MaizeShark/Nikon-NMEA-Pro/Nikon-GPS.step

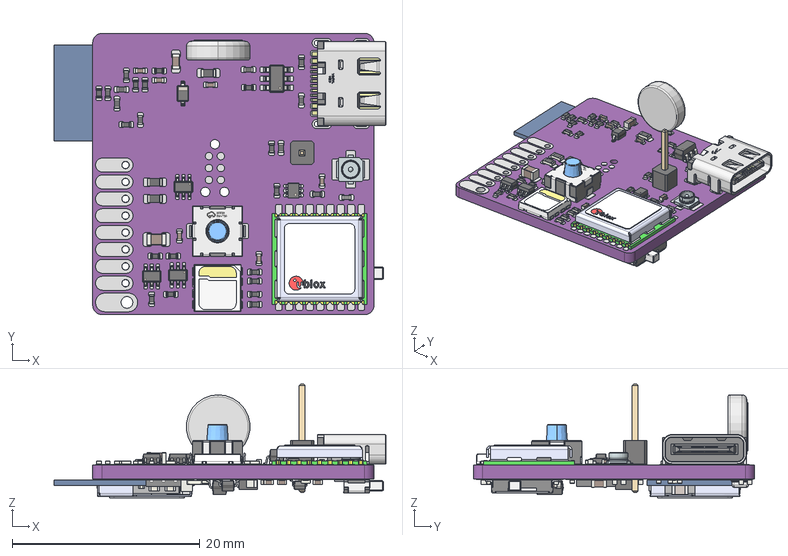
[picture p3: CAD file, 2026-11-05]
Nikon-GPS.step
35.4 x 30.0 x 12.1 mm
USB-C-SMD_G-SWITCH_GT-USB-7010ASV
C_0805_2012Metric x 2
D_SOD-323
C_0402_1005Metric x 14
GW J9LHS2.4M-C0C7-2+35+13+40AW-1 v4
R_0402_1005Metric x 32
R_0603_1608Metric x 3
SOT-363_SC-70-6 x 3
SOT_563
C_0603_1608Metric x 3
SOT-23-6
PinHeader_1x01_P254mm_Vertical
ML-621S_ZTN
KEY-SMD_2P-L5.3-W5.4-H4.3-LS5.4
u-blox_MAX_label_Default
Shield
MAX_PCB
L_0402_1005Metric
BMP581
SOT-23-5
SOT-23
R_Array_Convex_4x0603
WSON-8_L6.0-W5.0-H0.7-P1.27
LGA_12_2x2mm_P05mm
Extruded x 22
Extruded_2 x 3
Extruded_3 x 14
Extruded_4 x 2
Extruded_5
Extruded_6 x 12
Extruded_7 x 4
Extruded_8 x 2
Extruded_9 x 6
Extruded_10 x 3
Extruded_11
Extruded_12
Extruded_13 x 2
Extruded_14
BMD-340-341-pads
label_8x8
logo_x_4mm
logo_o_4mm
logo_l_4mm
logo_b_4mm
logo_u_4mm
pcb_1500_1020_056
BODY-SOT
LEAD-SOT x 6
PIN1-ID
Nikon-GPS-unsaved-export-hQPBzj_pad
Nikon-GPS-unsaved-export-hQPBzj_PCB
