MaizeShark/Nikon-NMEA-Pro/3D/FTSH-105-01-F-DV-K-P-TR.stp

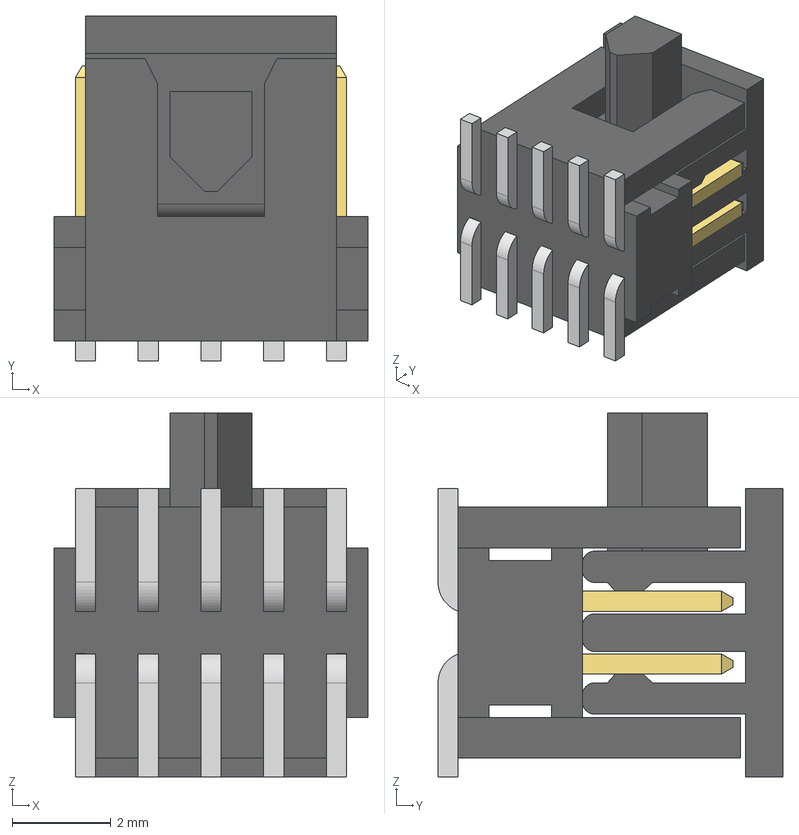
[picture p4: CAD file, 2026-10-20]
3D/FTSH-105-01-F-DV-K-P-TR.stp
6.35 x 6.98 x 7.37 mm
FTSH-105-01-F-DV-K-P-TR_body
FTSH-105-01-F-DV-K-P-TR_pins1
FTSH-105-01-F-DV-K-P-TR_pins2
FTSH-105-01-F-DV-K-P-TR_pp_pad
