MaizeShark/Nikon-NMEA-Pro/3D/VQFN-16_L3.0-W3.0-P0.50-TL-EP1.5.step

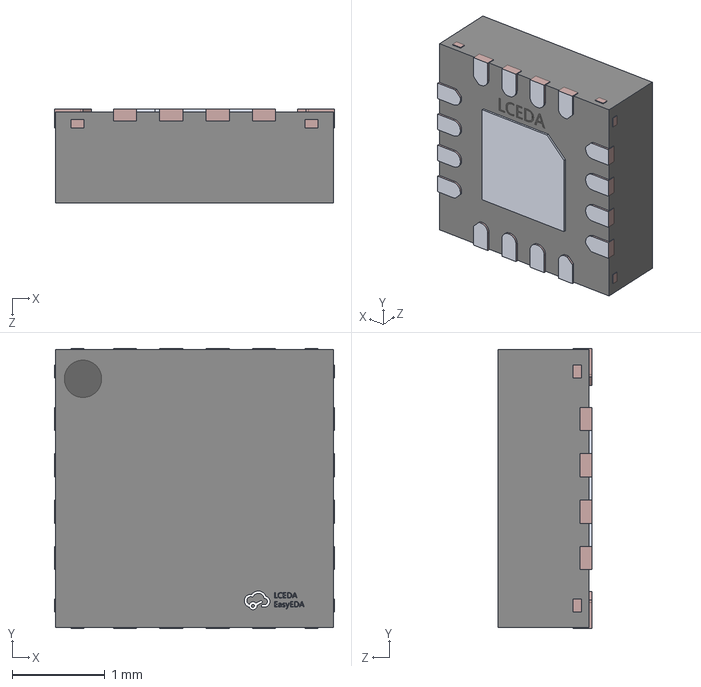
[picture p6: CAD file, 2026-10-20]
3D/VQFN-16_L3.0-W3.0-P0.50-TL-EP1.5.step
3.02 x 3.02 x 1.01 mm
