MaizeShark/Nikon-NMEA-Pro/3D/GW_J9LHS2.4M-C0C7-2+35+13+40AW-1.stp

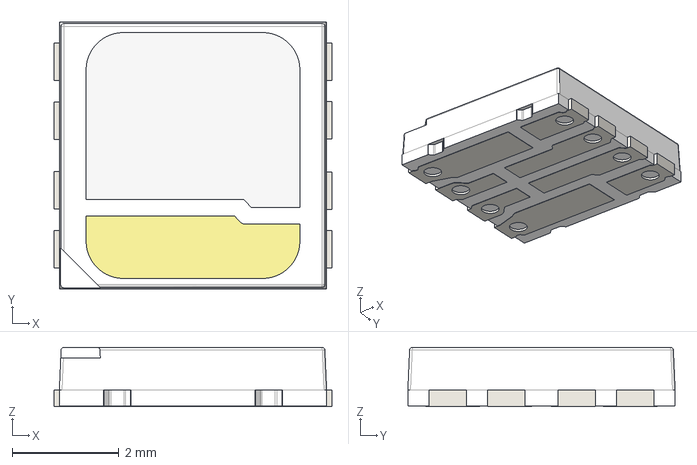
[picture p7: CAD file, 2026-10-20]
3D/GW_J9LHS2.4M-C0C7-2+35+13+40AW-1.stp
5.20 x 5.00 x 1.11 mm
