MaizeShark/Nikon-NMEA-Pro/3D/KEY-SMD_2P-L5.3-W5.4-H4.3-LS5.4.step

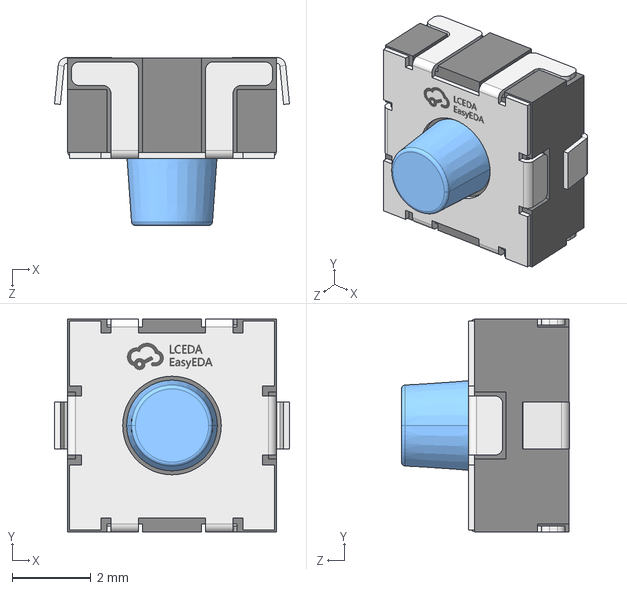
[picture p8: CAD file, 2026-10-20]
3D/KEY-SMD_2P-L5.3-W5.4-H4.3-LS5.4.step
5.96 x 5.40 x 4.26 mm
