MaizeShark/Nikon-NMEA-Pro/3D/SW-SMD_MSK12CO2-BDM.step

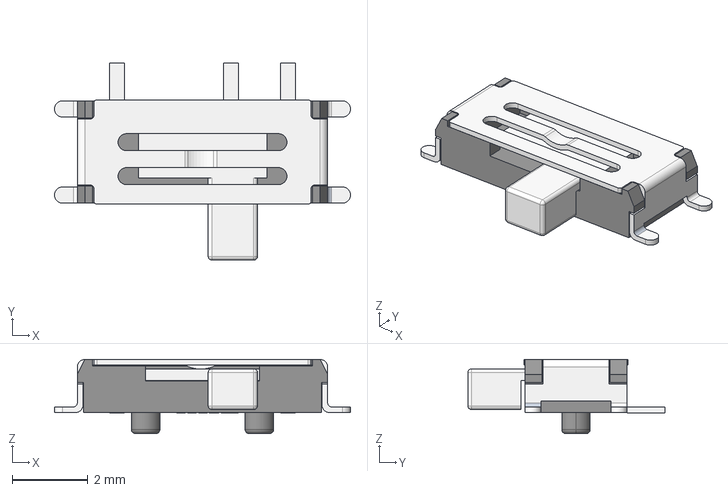
[picture p9: CAD file, 2026-10-20]
3D/SW-SMD_MSK12CO2-BDM.step
7.80 x 5.20 x 1.95 mm
