MaizeShark/Nikon-NMEA-Pro/3D/2042860001.stp

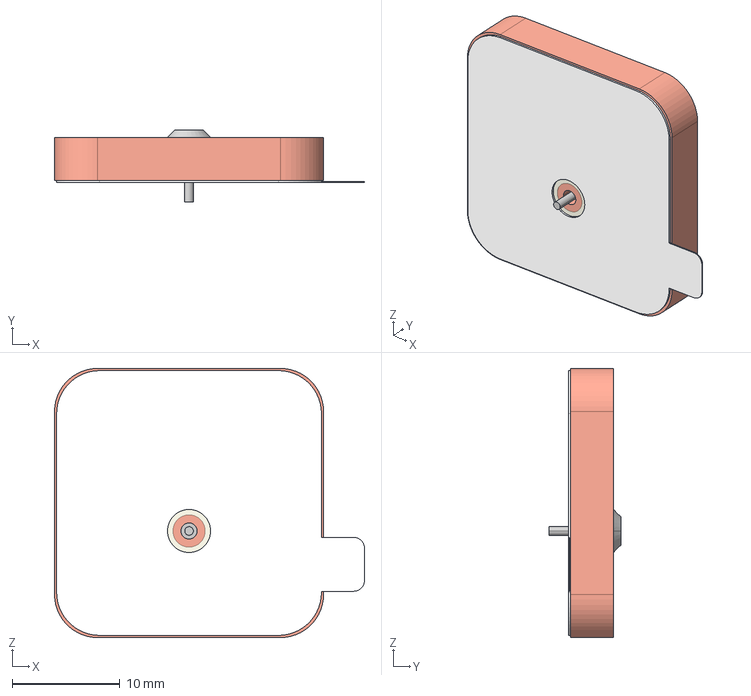
[picture p10: CAD file, 2026-10-20]
3D/2042860001.stp
28.8 x 6.70 x 25.0 mm
