MaizeShark/Nikon-NMEA-Pro/Nikon-GPS.kicad_pcb

## KiCad design Nikon-GPS.kicad_pcb (2026-11-05)

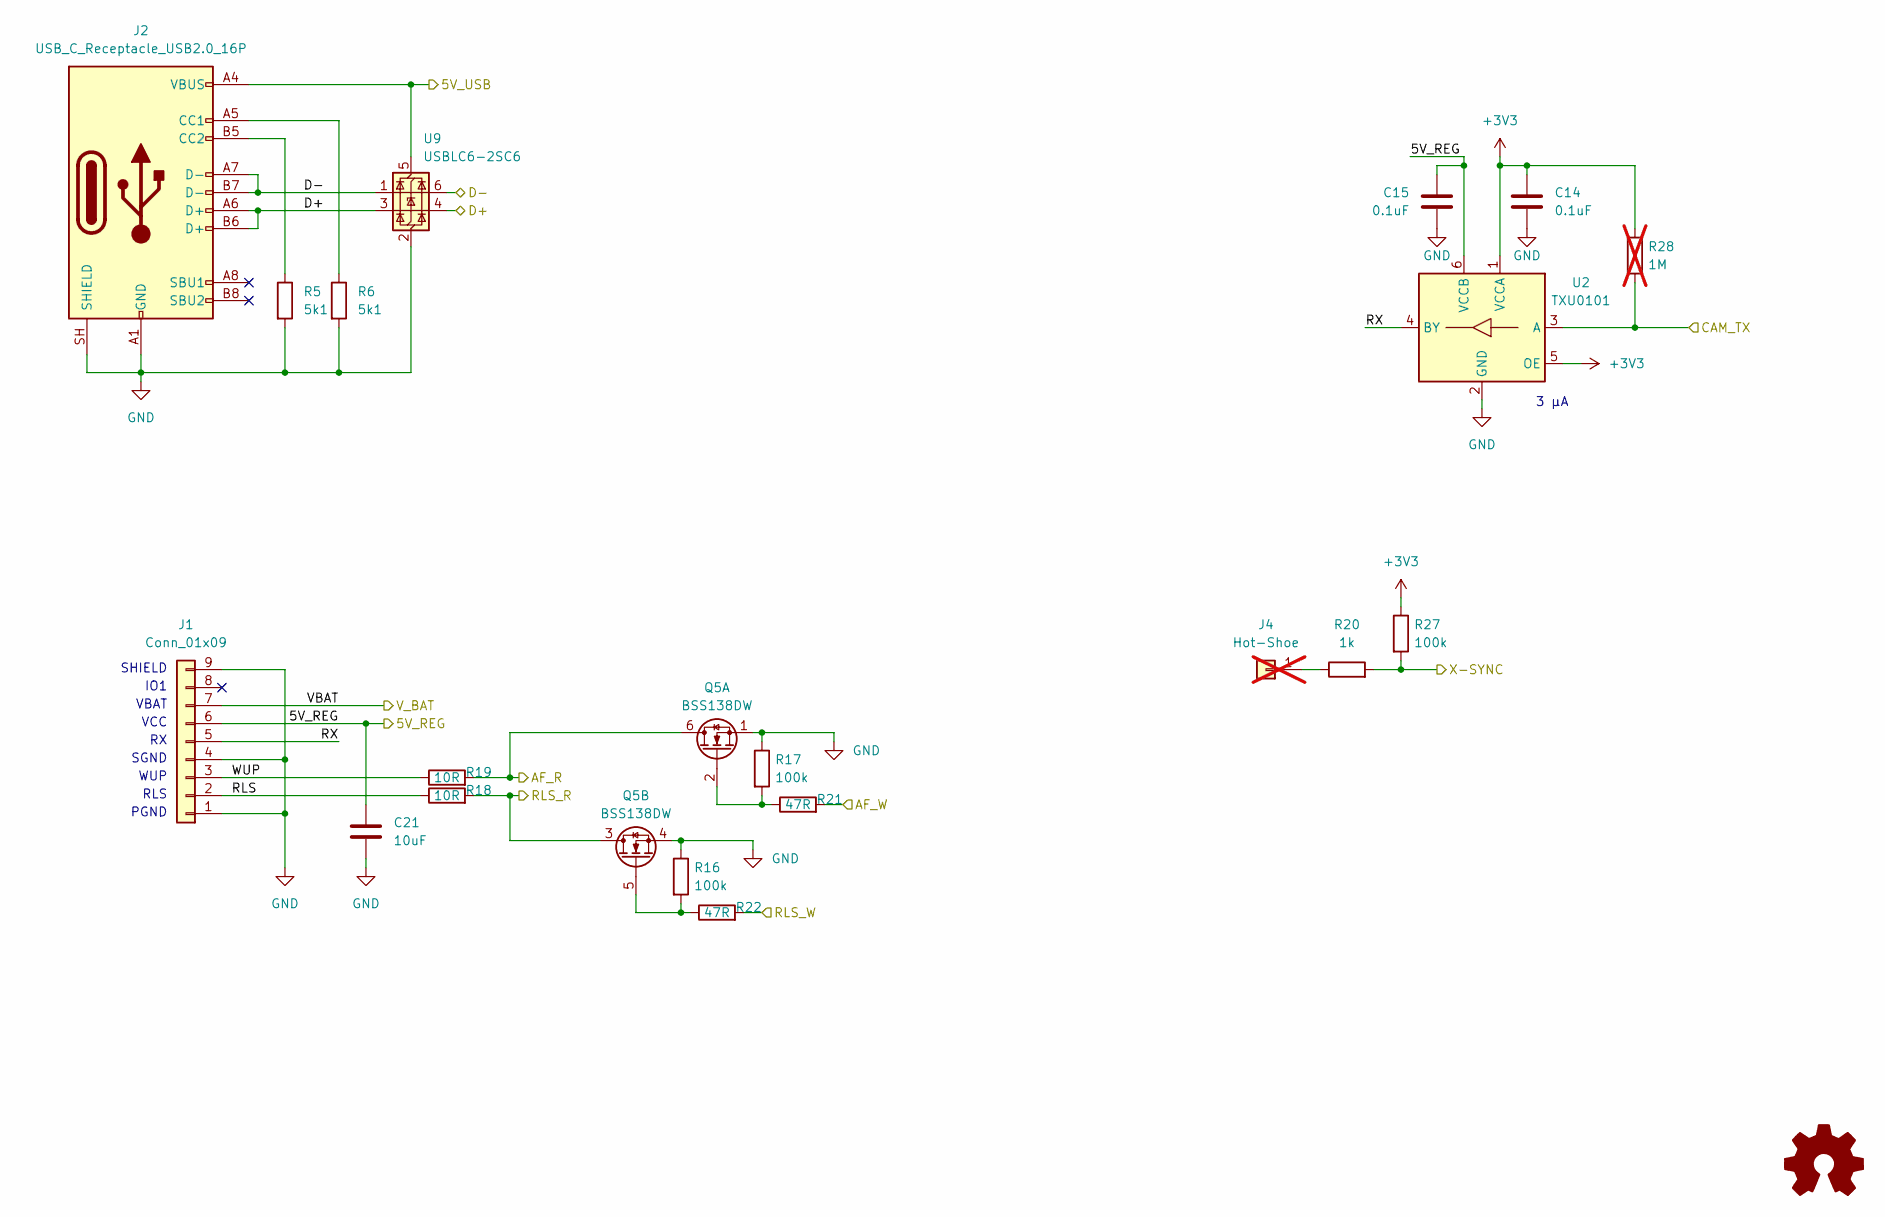
[picture p11: schematic connector.kicad_sch]

Parts:
C14, C15: 0.1uF; C_0402_1005Metric; LCSC C77020
C21: 10uF; C_0805_2012Metric; LCSC C32635
J1: Conn_01x09; Nikon Connector
J2: USB_C_Receptacle_USB2.0_16P; USB_C_Receptacle_G-Switch_GT-USB-7010ASV; LCSC C2988369
J4: Hot-Shoe; PinHeader_1x01_P2.54mm_Vertical; not fitted
Q5: BSS138DW; SOT-363_SC-70-6; LCSC C154900
R5, R6: 5k1; R_0402_1005Metric; LCSC C105872
R16, R17, R27: 100k; R_0402_1005Metric; LCSC C60491
R18, R19: 10R; R_0603_1608Metric; LCSC C109318
R20: 1k; R_0402_1005Metric; LCSC C106235
R21, R22: 47R; R_0402_1005Metric; LCSC C137973
R28: 1M; R_0402_1005Metric; LCSC C138033; not fitted
U2: TXU0101; Texas_DCK0006A_2.1x2mm_P0.65mm; LCSC C5217868
U9: USBLC6-2SC6; SOT-23-6; LCSC C5261088

Connections:
+3V3: C14.1, R27.1, R28.1, U2.1 (VCCA), U2.5 (OE); also elsewhere on the board
/Connector/5V_REG: C15.1, C21.1, J1.6, U2.6 (VCCB); also elsewhere on the board
/Connector/5V_USB: J2.A4 (VBUS), J2.A9 (VBUS), J2.B4 (VBUS), J2.B9 (VBUS), U9.5 (VBUS); also elsewhere on the board
/Connector/AF_R: Q5.6 (D1), R19.2; also elsewhere on the board
/Connector/AF_W: R21.2; also elsewhere on the board
/Connector/CAM_TX: R28.2, U2.3 (A); also elsewhere on the board
/Connector/D+: J2.A6 (D+), J2.B6 (D+), U9.3 (I/O2), U9.4 (I/O2); also elsewhere on the board
/Connector/D-: J2.A7 (D-), J2.B7 (D-), U9.1 (I/O1), U9.6 (I/O1); also elsewhere on the board
/Connector/RLS: J1.2, R18.1
/Connector/RLS_R: Q5.3 (D2), R18.2; also elsewhere on the board
/Connector/RLS_W: R22.2; also elsewhere on the board
/Connector/RX: J1.5, U2.4 (BY)
/Connector/VBAT: J1.7; also elsewhere on the board
/Connector/WUP: J1.3, R19.1
/Connector/X-SYNC: R20.2, R27.2; also elsewhere on the board
GND: C14.2, C15.2, C21.2, J1.1, J1.4, J1.9, J2.A1 (GND), J2.A12 (GND), J2.B1 (GND), J2.B12 (GND), J2.SH (SHIELD), Q5.1 (S1), Q5.4 (S2), R5.2, R6.2, R16.1, R17.1, U2.2 (GND), U9.2 (GND); also elsewhere on the board
unnamed: J2.A5 (CC1), R6.1
unnamed: J2.B5 (CC2), R5.1
unnamed: J4.1 (Pin_1_1), R20.1
unnamed: Q5.2 (G1), R17.2, R21.1
unnamed: Q5.5 (G2), R16.2, R22.1

Notes on the sheet:
VBAT
WUP
RLS
PGND
IO1
3 μA
SGND
SHIELD
VCC

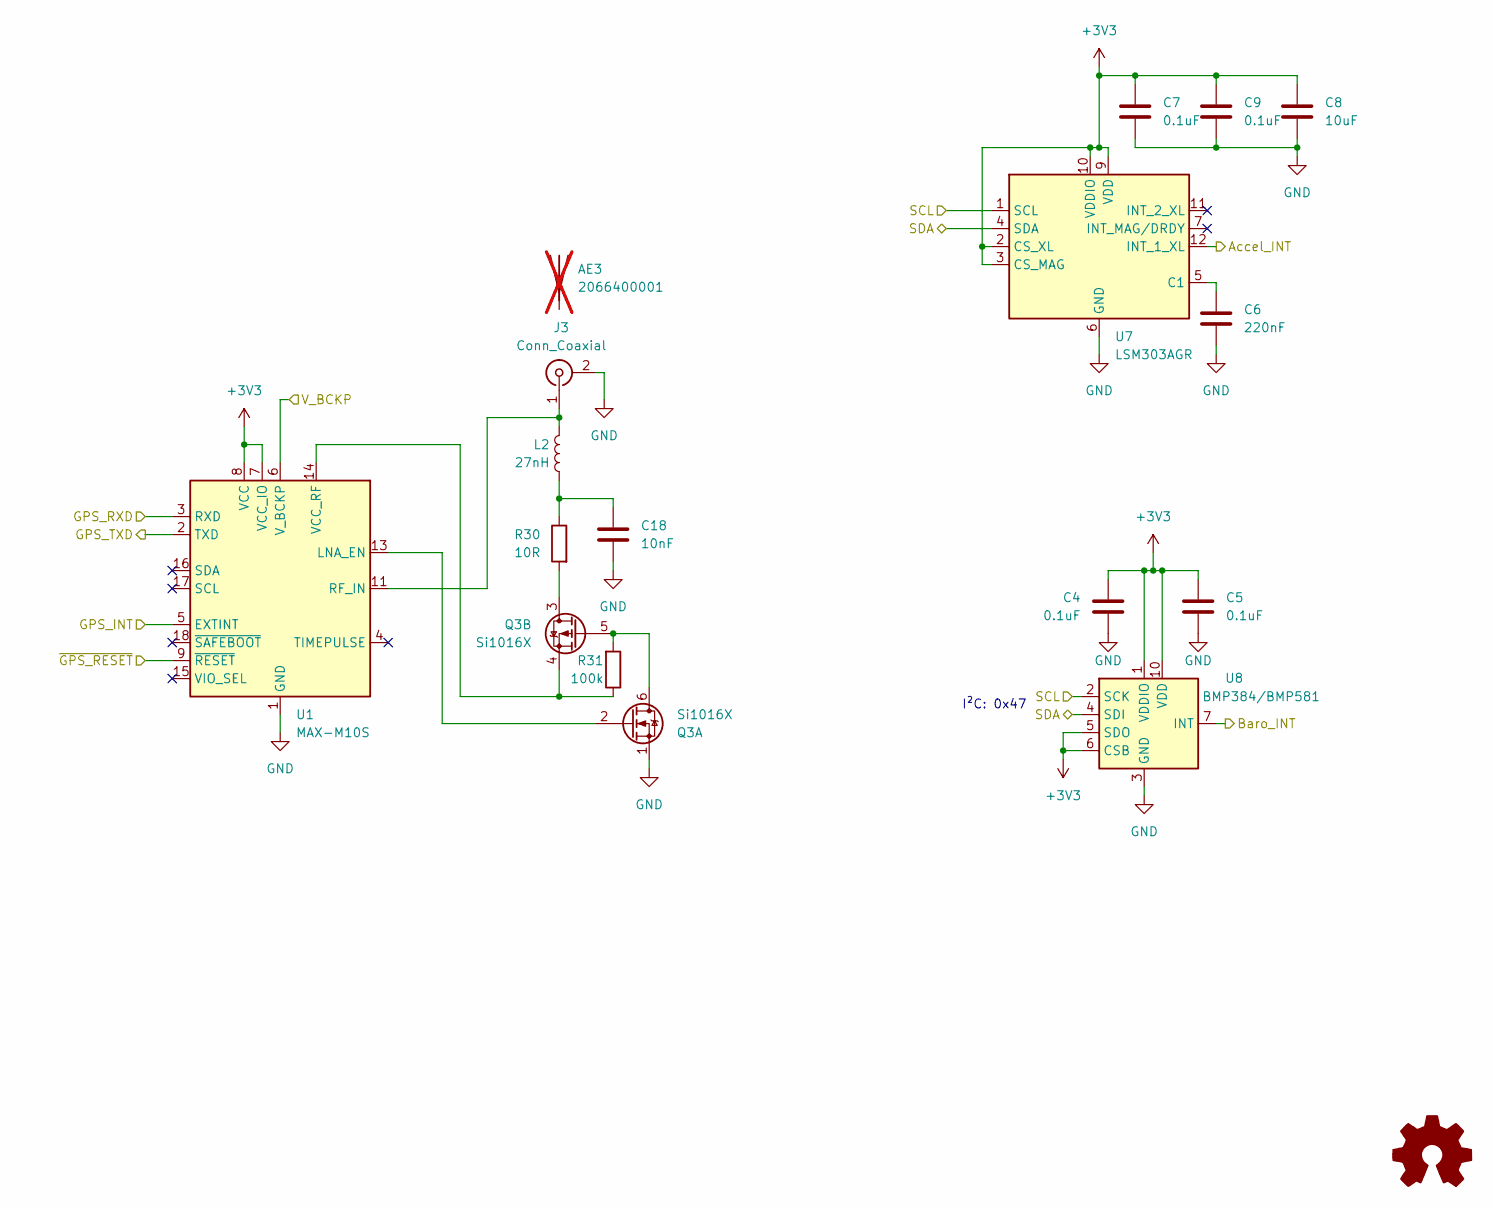
[picture p12: schematic sensors.kicad_sch]

Parts:
AE3: 2066400001; 2042860001; LCSC C841211; not fitted
C4, C5, C7, C9: 0.1uF; C_0402_1005Metric; LCSC C77020
C6: 220nF; C_0402_1005Metric; LCSC C696846
C8: 10uF; C_0603_1608Metric; LCSC C19702
C18: 10nF; C_0402_1005Metric; LCSC C85735
J3: Conn_Coaxial; U.FL_Molex_MCRF_73412-0110_Vertical; LCSC C41375966
L2: 27nH; L_0402_1005Metric; LCSC C12669
Q3: Si1016X; SOT-563; LCSC C50314620
R30: 10R; R_0402_1005Metric; LCSC C138066
R31: 100k; R_0402_1005Metric; LCSC C60491
U1: MAX-M10S; ublox_MAX; LCSC C4153167
U7: LSM303AGR; LGA-12_2x2mm_P0.5mm; LCSC C126671
U8: BMP384/BMP581; Bosch_WFLGA-10_2x2mm_P0.5mm; LCSC C5362283

Connections:
+3V3: C4.1, C5.1, C7.1, C8.1, C9.1, U1.7 (VCC_IO), U1.8 (VCC), U7.2 (CS_XL), U7.3 (CS_MAG), U7.9 (VDD), U7.10 (VDDIO), U8.1 (VDDIO), U8.5 (SDO), U8.6 (CSB), U8.10 (VDD); also elsewhere on the board
/MCU/Accel_INT: U7.12 (INT_1_XL); also elsewhere on the board
/MCU/Baro_INT: U8.7 (INT); also elsewhere on the board
/MCU/GPS_INT: U1.5 (EXTINT); also elsewhere on the board
/MCU/GPS_RXD: U1.2 (TXD); also elsewhere on the board
/MCU/GPS_TXD: U1.3 (RXD); also elsewhere on the board
/MCU/SCL: U7.1 (SCL), U8.2 (SCK); also elsewhere on the board
/MCU/SDA: U7.4 (SDA), U8.4 (SDI); also elsewhere on the board
/MCU/~GPS_RESET: U1.9 (~RESET); also elsewhere on the board
/Power/V_BCKP: U1.6 (V_BCKP); also elsewhere on the board
GND: C4.2, C5.2, C6.2, C7.2, C8.2, C9.2, C18.2, J3.2 (Ext), Q3.1 (SN), U1.1 (GND), U1.10 (GND), U1.12 (GND), U7.6 (GND), U7.8 (GND), U8.3 (GND), U8.8 (GND), U8.9 (GND), U8.[8,9] (GND); also elsewhere on the board
unnamed: C18.1, L2.2, R30.1
unnamed: J3.1 (In), L2.1, U1.11 (RF_IN)
unnamed: Q3.5 (GP), Q3.6 (DN), R31.2
unnamed: Q3.2 (GN), U1.13 (LNA_EN)
unnamed: Q3.3 (DP), R30.2
unnamed: Q3.4 (SP), R31.1, U1.14 (VCC_RF)
unnamed: C6.1, U7.5 (C1)

Notes on the sheet:
I²C: 0x47

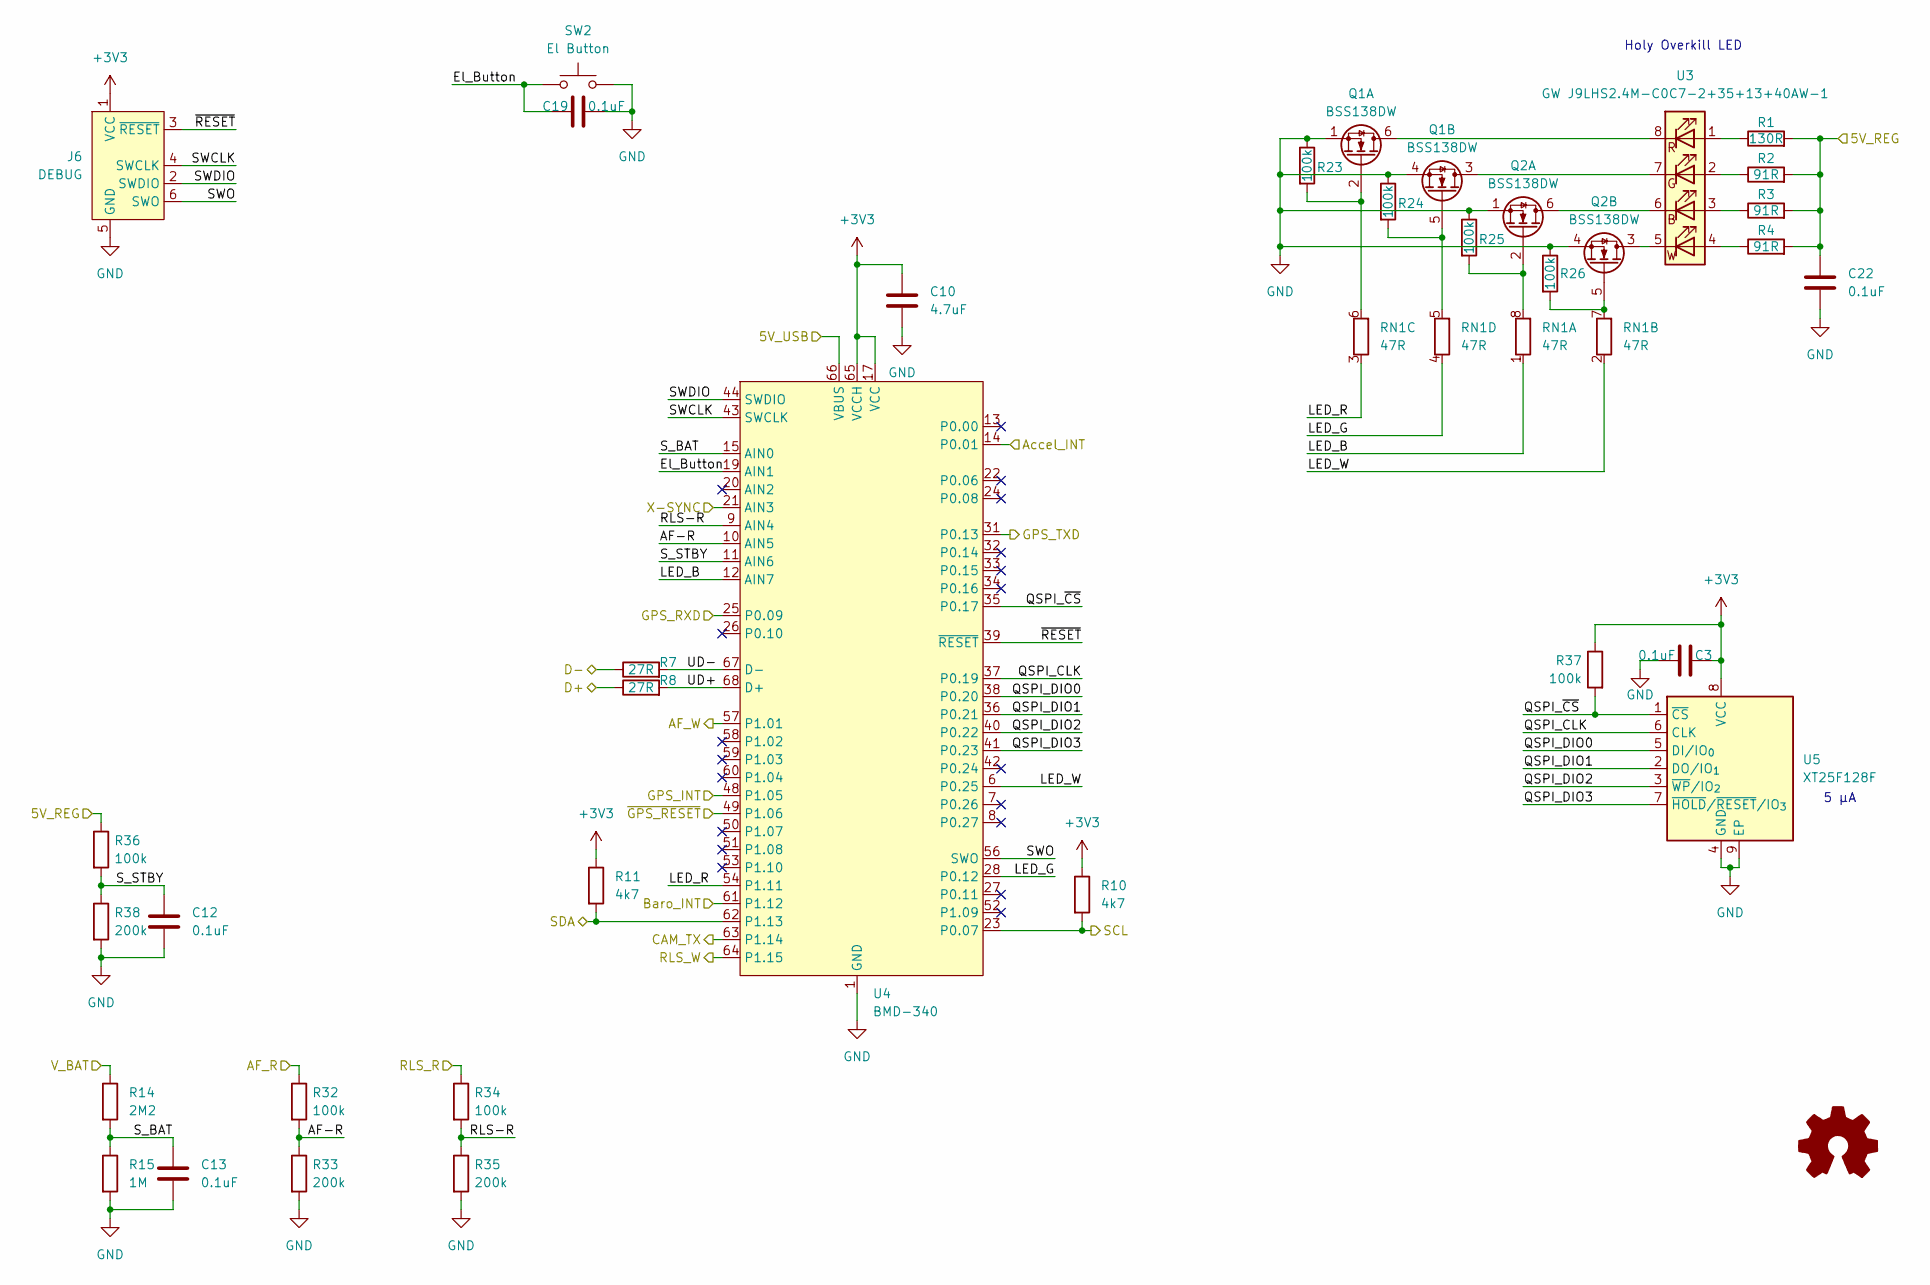
[picture p13: schematic mcu.kicad_sch]

Parts:
C3, C12, C13, C19, C22: 0.1uF; C_0402_1005Metric; LCSC C77020
C10: 4.7uF; C_0603_1608Metric; LCSC C1705
J6: DEBUG; Tag-Connect_TC2030-IDC-NL_2x03_P1.27mm_Vertical
Q1, Q2: BSS138DW; SOT-363_SC-70-6; LCSC C154900
R1: 130R; R_0402_1005Metric; LCSC C413066
R2, R3, R4: 91R; R_0402_1005Metric; LCSC C2998110
R7, R8: 27R; R_0402_1005Metric; LCSC C2909343
R10, R11: 4k7; R_0402_1005Metric; LCSC C105871
R14: 2M2; R_0402_1005Metric; LCSC C2998080
R15: 1M; R_0402_1005Metric; LCSC C138033
R23, R24, R25, R26, R32, R34, R36, R37: 100k; R_0402_1005Metric; LCSC C60491
R33, R35, R38: 200k; R_0402_1005Metric; LCSC C2906866
RN1: 47R; R_Array_Convex_4x0603; LCSC C16081
SW2: El Button; SKSUAAE010
U3: GW J9LHS2.4M-C0C7-2+35+13+40AW-1; GW J9LHS2.4M; LCSC C5648656
U4: BMD-340; LCSC C5456944
U5: XT25F128F; WSON-8-1EP_6x5mm_P1.27mm_EP3.4x4mm; LCSC C3202839

Connections:
+3V3: C3.2, C10.1, J6.1 (VCC), R10.1, R11.1, R37.1, U4.17 (VCC), U4.65 (VCCH), U5.8 (VCC); also elsewhere on the board
/Connector/5V_REG: C22.1, R1.2, R2.2, R3.2, R4.2, R36.1; also elsewhere on the board
/Connector/5V_USB: U4.66 (VBUS); also elsewhere on the board
/Connector/AF_R: R32.1; also elsewhere on the board
/Connector/AF_W: U4.57 (P1.01); also elsewhere on the board
/Connector/CAM_TX: U4.63 (P1.14); also elsewhere on the board
/Connector/D+: R8.1; also elsewhere on the board
/Connector/D-: R7.1; also elsewhere on the board
/Connector/RLS_R: R34.1; also elsewhere on the board
/Connector/RLS_W: U4.64 (P1.15); also elsewhere on the board
/Connector/VBAT: R14.1; also elsewhere on the board
/Connector/X-SYNC: U4.21 (AIN3); also elsewhere on the board
/MCU/AF-R: R32.2, R33.1, U4.10 (AIN5)
/MCU/Accel_INT: U4.14 (P0.01); also elsewhere on the board
/MCU/Baro_INT: U4.61 (P1.12); also elsewhere on the board
/MCU/El_Button: C19.1, SW2.1, U4.19 (AIN1)
/MCU/GPS_INT: U4.48 (P1.05); also elsewhere on the board
/MCU/GPS_RXD: U4.25 (P0.09); also elsewhere on the board
/MCU/GPS_TXD: U4.31 (P0.13); also elsewhere on the board
/MCU/LED_B: RN1.1 (R1.1), U4.12 (AIN7)
/MCU/LED_G: RN1.4 (R4.1), U4.28 (P0.12)
/MCU/LED_R: RN1.3 (R3.1), U4.54 (P1.11)
/MCU/LED_W: RN1.2 (R2.1), U4.6 (P0.25)
/MCU/QSPI_CLK: U4.37 (P0.19), U5.6 (CLK)
/MCU/QSPI_DIO0: U4.38 (P0.20), U5.5 (DI/IO_{0})
/MCU/QSPI_DIO1: U4.36 (P0.21), U5.2 (DO/IO_{1})
/MCU/QSPI_DIO2: U4.40 (P0.22), U5.3 (~WP/IO_{2})
/MCU/QSPI_DIO3: U4.41 (P0.23), U5.7 (~HOLD/~RESET/IO_{3})
/MCU/QSPI_~CS: R37.2, U4.35 (P0.17), U5.1 (~CS)
/MCU/RLS-R: R34.2, R35.1, U4.9 (AIN4)
/MCU/SCL: R10.2, U4.23 (P0.07); also elsewhere on the board
/MCU/SDA: R11.2, U4.62 (P1.13); also elsewhere on the board
/MCU/SWCLK: J6.4 (SWCLK), U4.43 (SWCLK)
/MCU/SWDIO: J6.2 (SWDIO), U4.44 (SWDIO)
/MCU/SWO: J6.6 (SWO), U4.56 (SWO)
/MCU/S_BAT: C13.1, R14.2, R15.1, U4.15 (AIN0)
/MCU/S_STBY: C12.1, R36.2, R38.1, U4.11 (AIN6)
/MCU/UD+: R8.2, U4.68 (D+)
/MCU/UD-: R7.2, U4.67 (D-)
/MCU/~GPS_RESET: U4.49 (P1.06); also elsewhere on the board
/MCU/~RESET: J6.3 (~RESET), U4.39 (~RESET)
GND: C3.1, C10.2, C12.2, C13.2, C19.2, C22.2, J6.5 (GND), Q1.1 (S1), Q1.4 (S2), Q2.1 (S1), Q2.4 (S2), R15.2, R23.1, R24.1, R25.1, R26.1, R33.2, R35.2, R38.2, SW2.2, U4.1 (GND), U4.2 (GND), U4.3 (GND), U4.4 (GND), U4.5 (GND), U4.16 (GND), U4.18 (GND), U4.29 (GND), U4.30 (GND), U4.45 (GND), U4.46 (GND), U4.47 (GND), U4.55 (GND), U4.[2-5,16,18,29,30,45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 (GND), U5.4 (GND), U5.9 (EP); also elsewhere on the board
unnamed: Q1.6 (D1), U3.8 (RK)
unnamed: Q1.2 (G1), R23.2, RN1.6 (R3.2)
unnamed: Q1.3 (D2), U3.7 (GK)
unnamed: Q1.5 (G2), R24.2, RN1.5 (R4.2)
unnamed: Q2.6 (D1), U3.6 (BK)
unnamed: Q2.2 (G1), R25.2, RN1.8 (R1.2)
unnamed: Q2.3 (D2), U3.5 (WK)
unnamed: Q2.5 (G2), R26.2, RN1.7 (R2.2)
unnamed: R3.1, U3.3 (BA)
unnamed: R2.1, U3.2 (GA)
unnamed: R1.1, U3.1 (RA)
unnamed: R4.1, U3.4 (WA)

Notes on the sheet:
Holy Overkill LED
5 μA

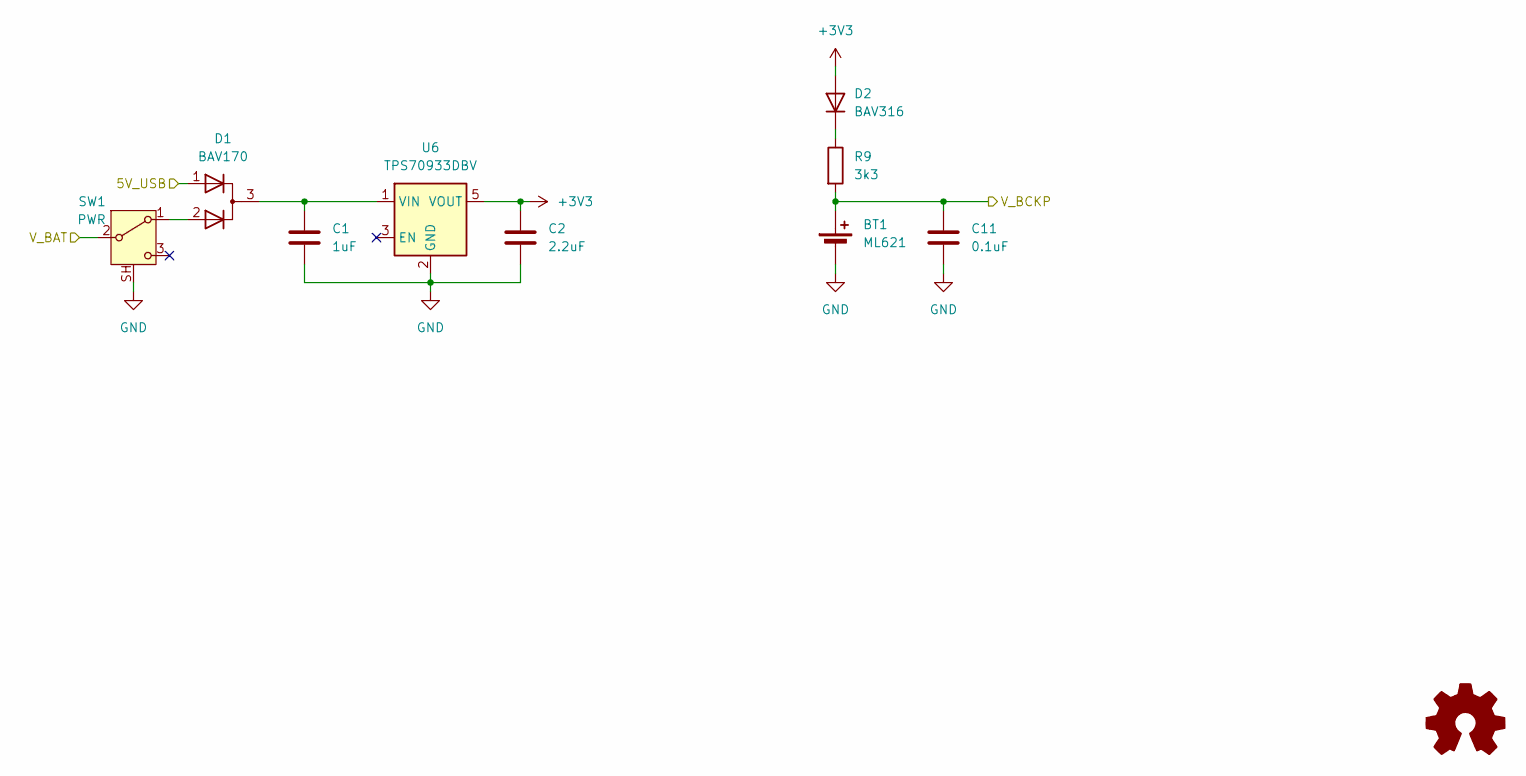
[picture p14: schematic power.kicad_sch]

Parts:
BT1: ML621; Battery_Panasonic_ML621_Vertical
C1: 1uF; C_0805_2012Metric; LCSC C344178
C2: 2.2uF; C_0603_1608Metric; LCSC C57895
C11: 0.1uF; C_0402_1005Metric; LCSC C77020
D1: BAV170; SOT-23; LCSC C109309
D2: BAV316; D_SOD-323; LCSC C3031914
R9: 3k3; R_0603_1608Metric; LCSC C22978
SW1: PWR; SW_SPDT_Shouhan_MSK12C02; LCSC C2681566
U6: TPS70933DBV; SOT-23-5_HandSoldering; LCSC C90991

Connections:
+3V3: C2.1, D2.2 (A), U6.5 (VOUT); also elsewhere on the board
/Connector/5V_USB: D1.1 (A); also elsewhere on the board
/Connector/VBAT: SW1.2 (B); also elsewhere on the board
/Power/V_BCKP: BT1.1 (+), C11.1, R9.2; also elsewhere on the board
GND: BT1.2 (-), C1.2, C2.2, C11.2, SW1.SH (MP), U6.2 (GND); also elsewhere on the board
unnamed: C1.1, D1.3 (K), U6.1 (VIN)
unnamed: D2.1 (K), R9.1
unnamed: D1.2 (A), SW1.1 (A)

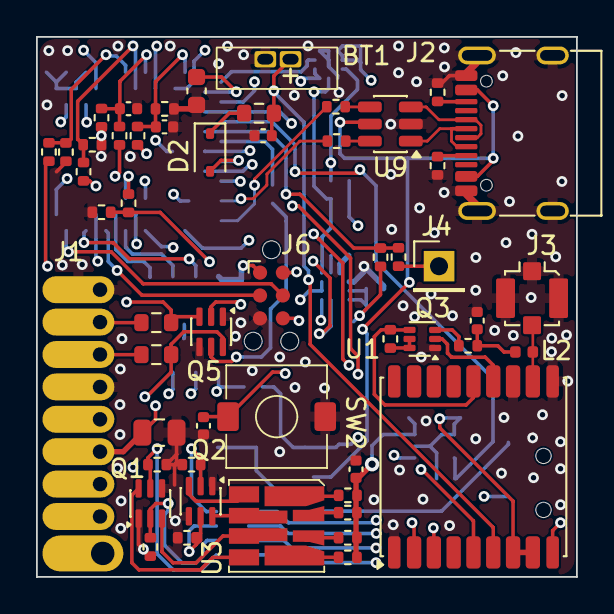
[picture p15: board Nikon-GPS.kicad_pcb from above]

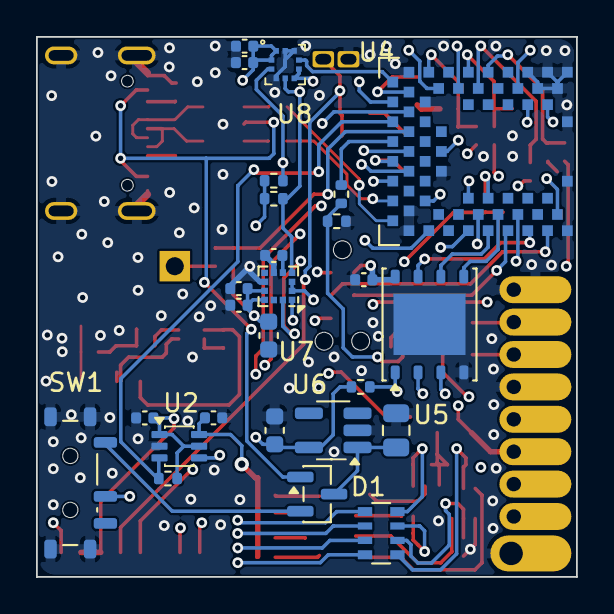
[picture p16: board Nikon-GPS.kicad_pcb from below]

Board: 4 copper layers, 30.0 x 30.0 mm, 79 parts (26 on the bottom side), 73 nets.
