MaizeShark/Nikon-NMEA-Pro/(notices)

Notices in the files:
3D/FTSH-105-01-F-DV-K-P-TR.stp:
author */ ('License CC BY-ND 4.0'),
